k5nty/Kolos/images/printed-chamber.jpg

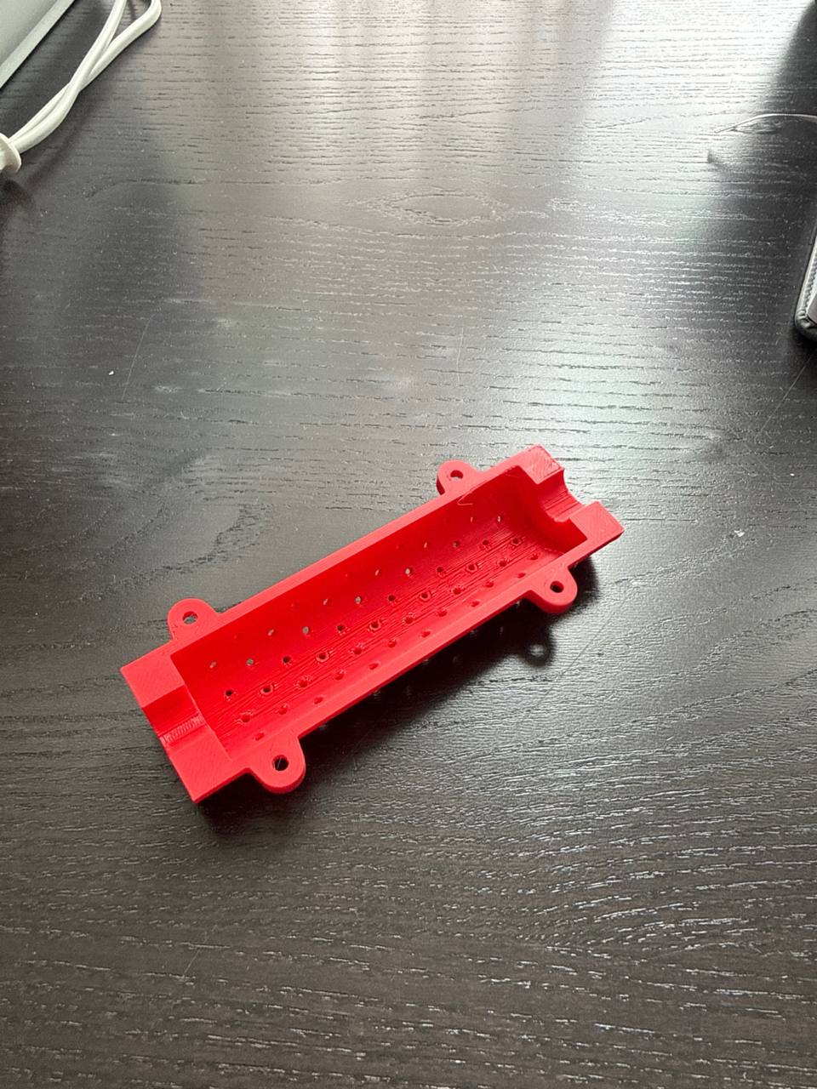
images/printed-chamber.jpg
