k5nty/Kolos/images/microphone.jpg

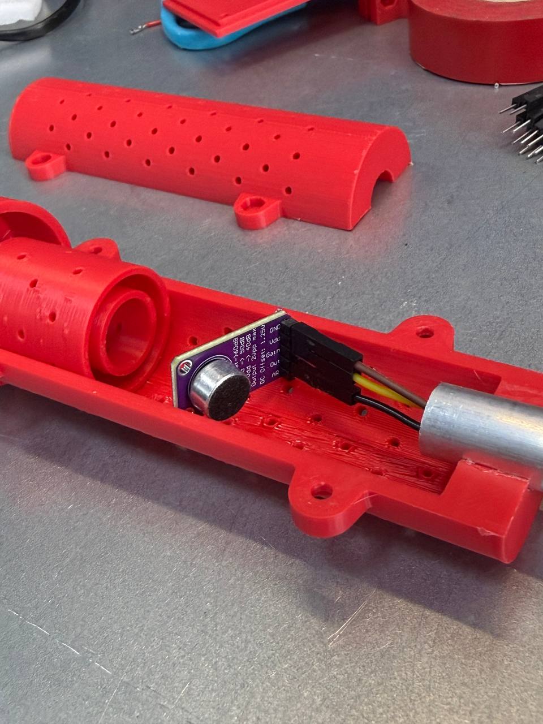
images/microphone.jpg
