k5nty/Kolos/images/chamber-3d.png

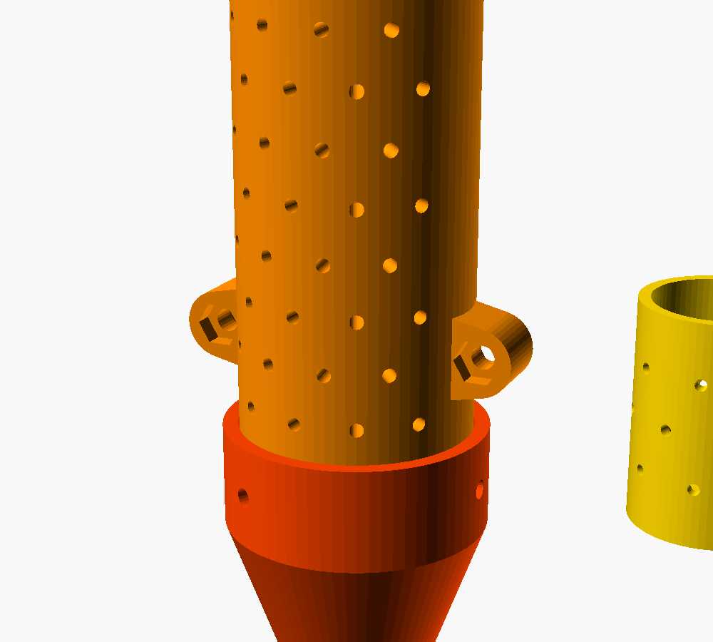
images/chamber-3d.png
