k5nty/Kolos/images/chamber-closed.jpg

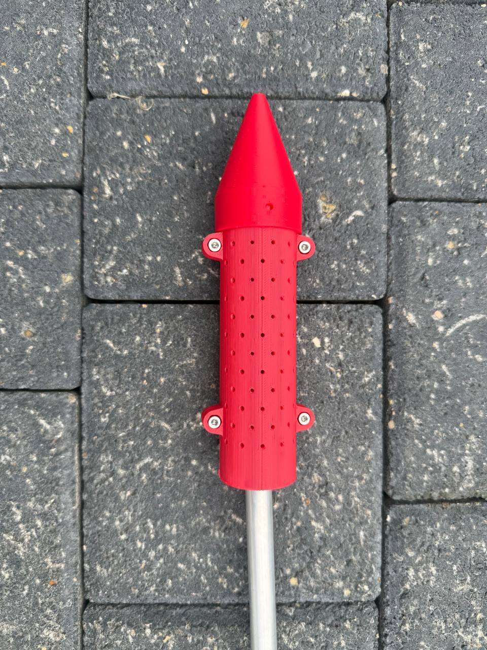
images/chamber-closed.jpg
