k5nty/Kolos/images/chamber-open-side.jpg

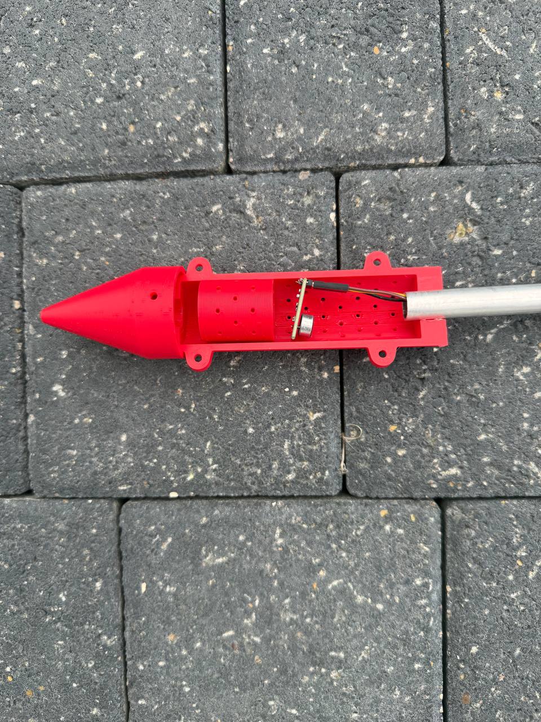
images/chamber-open-side.jpg
