k5nty/Kolos/images/chamber-open.jpg

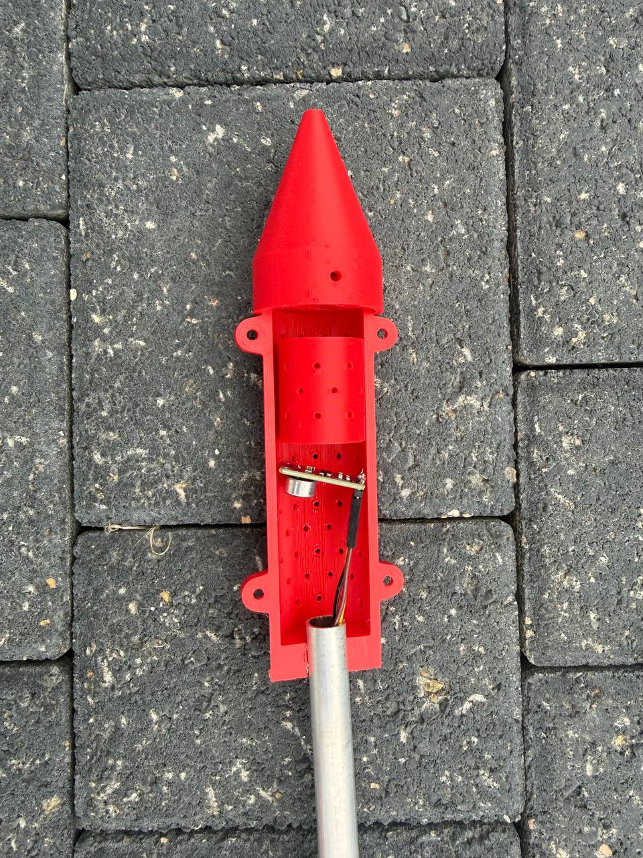
images/chamber-open.jpg
