k5nty/Kolos/images/dashboard-overview.jpg

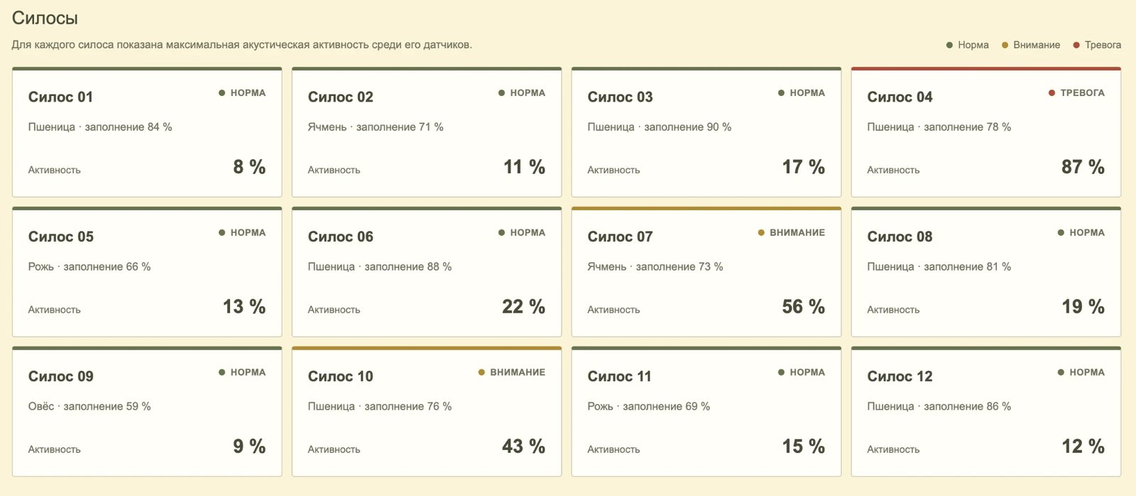
images/dashboard-overview.jpg
