k5nty/Kolos/images/dashboard-silo.jpg

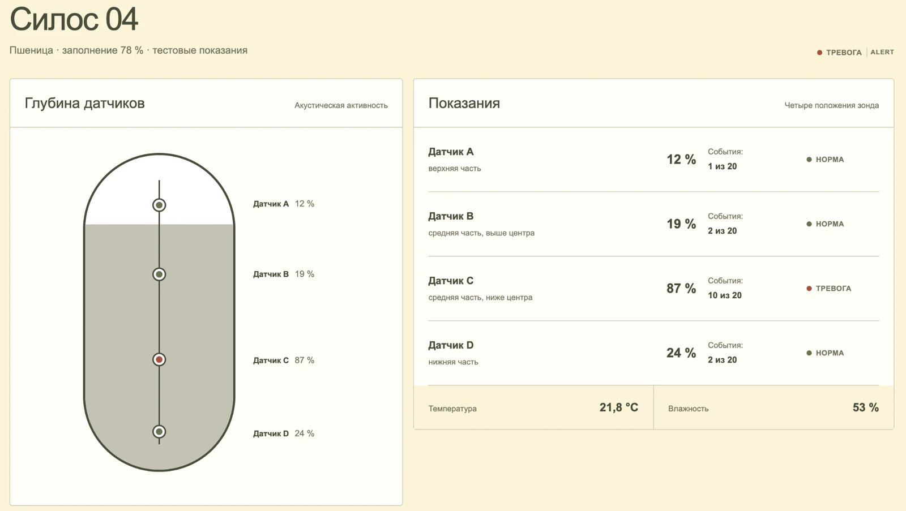
images/dashboard-silo.jpg
