k5nty/Kolos/images/esp32-box.jpg

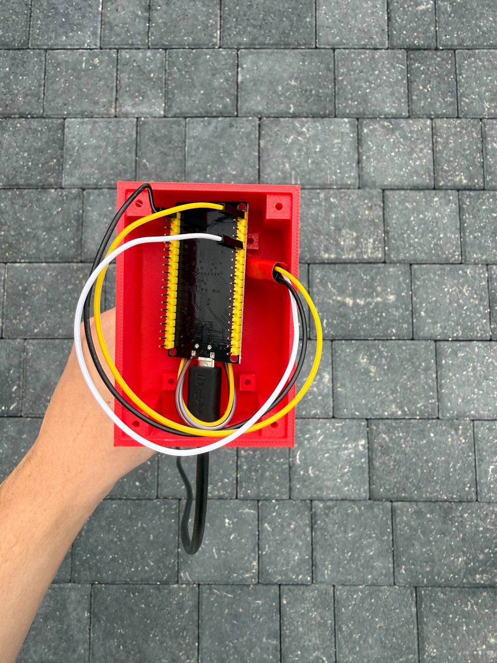
images/esp32-box.jpg
