k5nty/Kolos/images/live-recognition.jpg

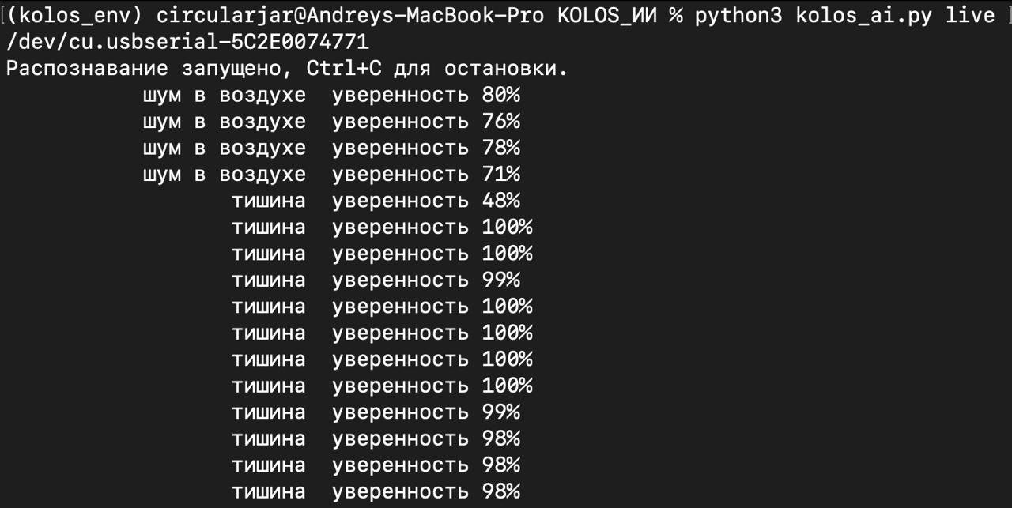
images/live-recognition.jpg
