k5nty/Kolos/images/paper-cover.jpg

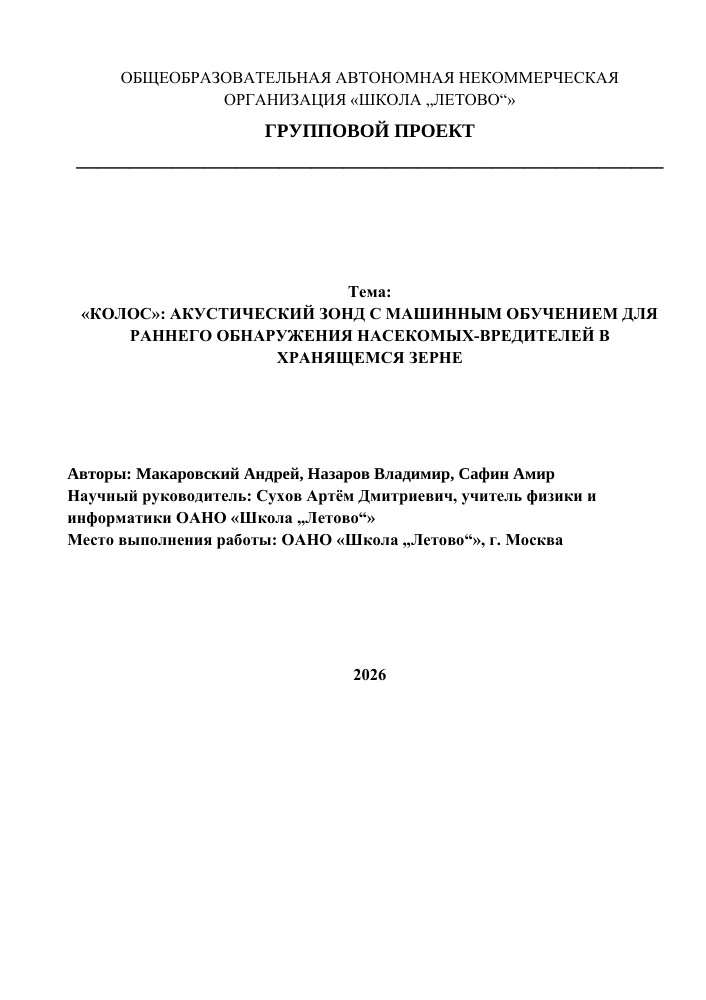
images/paper-cover.jpg
