k5nty/Kolos/images/probe-3d.png

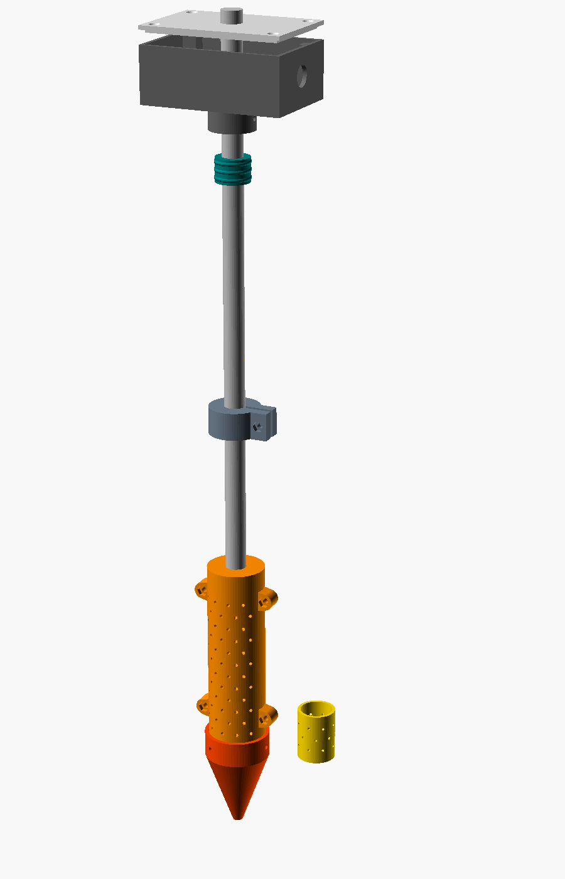
images/probe-3d.png
