k5nty/Kolos/images/probe-desk.jpg

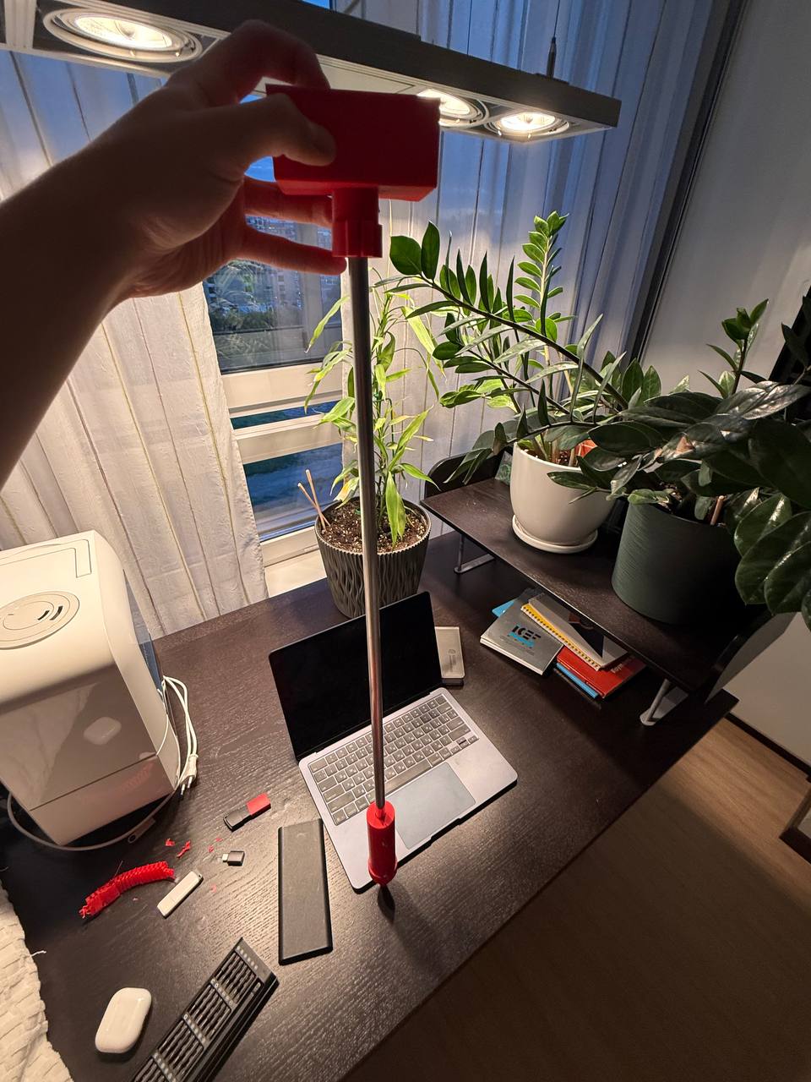
images/probe-desk.jpg
