k5nty/Kolos/images/probe-full-2.jpg

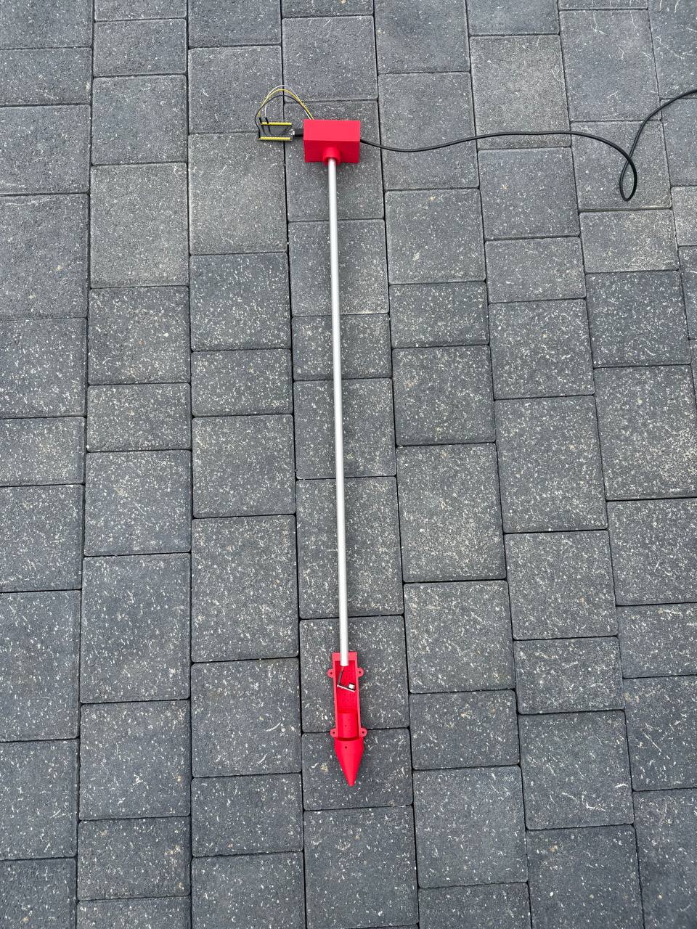
images/probe-full-2.jpg
