k5nty/Kolos/images/probe-full.jpg

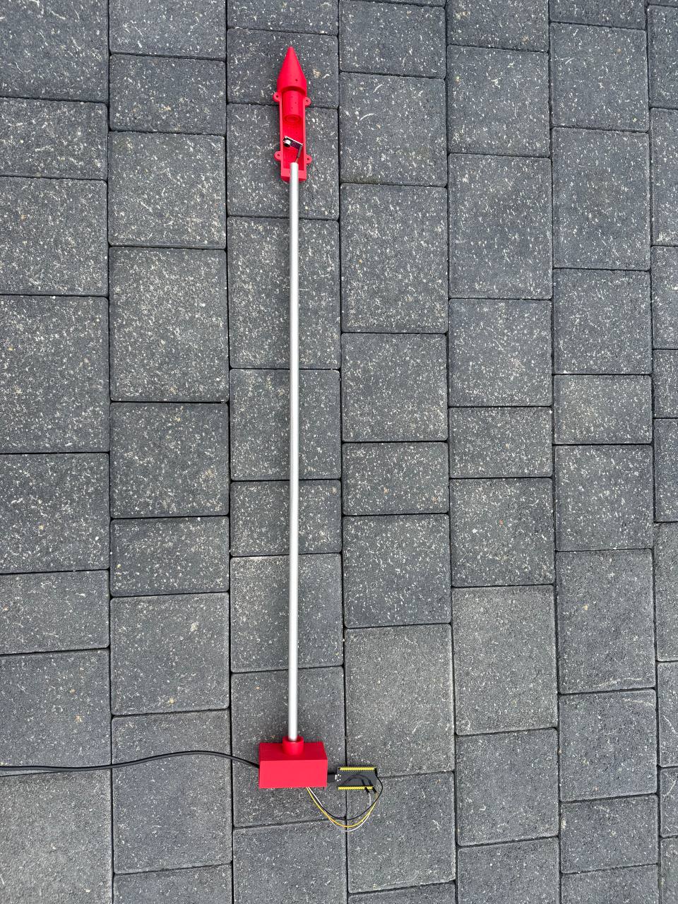
images/probe-full.jpg
